johnobrien/printnc/VFD_Modbus_Control/VFD_Modbus_Wiring_Schematic.pdf

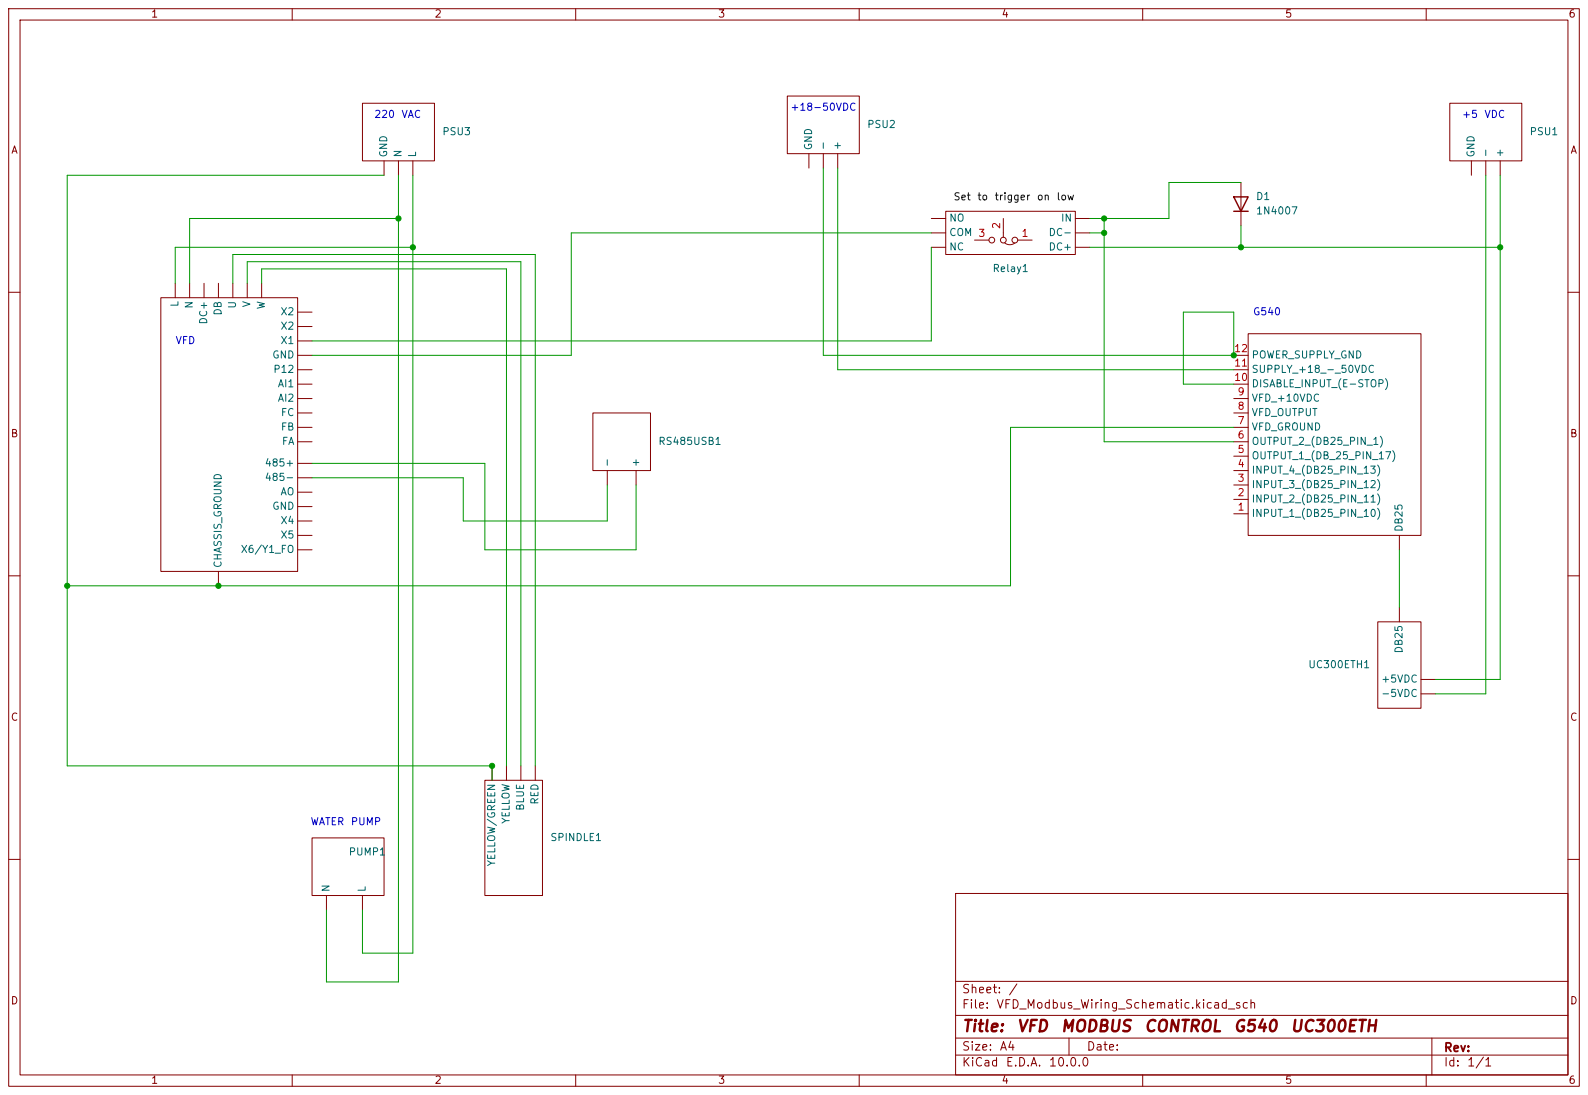
[picture p1: page 1]

Set to trigger on low WATER PUMP

Sheet: / YELLOW/GREEN YELLOW BLUE RED

File: VFD_Modbus_Wiring_Schematic.kicad_sch
Title: VFD MODBUS CONTROL G540 UC300ETH

Size: A4 | Rev:
KiCad E.D.A. 10.0.0 | Id: 1/1
