johnobrien/printnc/VFD_Voltage_Control/VFD_Voltage_Control_Wiring_Schematic.kicad_pcb

## KiCad design v2v 1.2 .kicad_sch

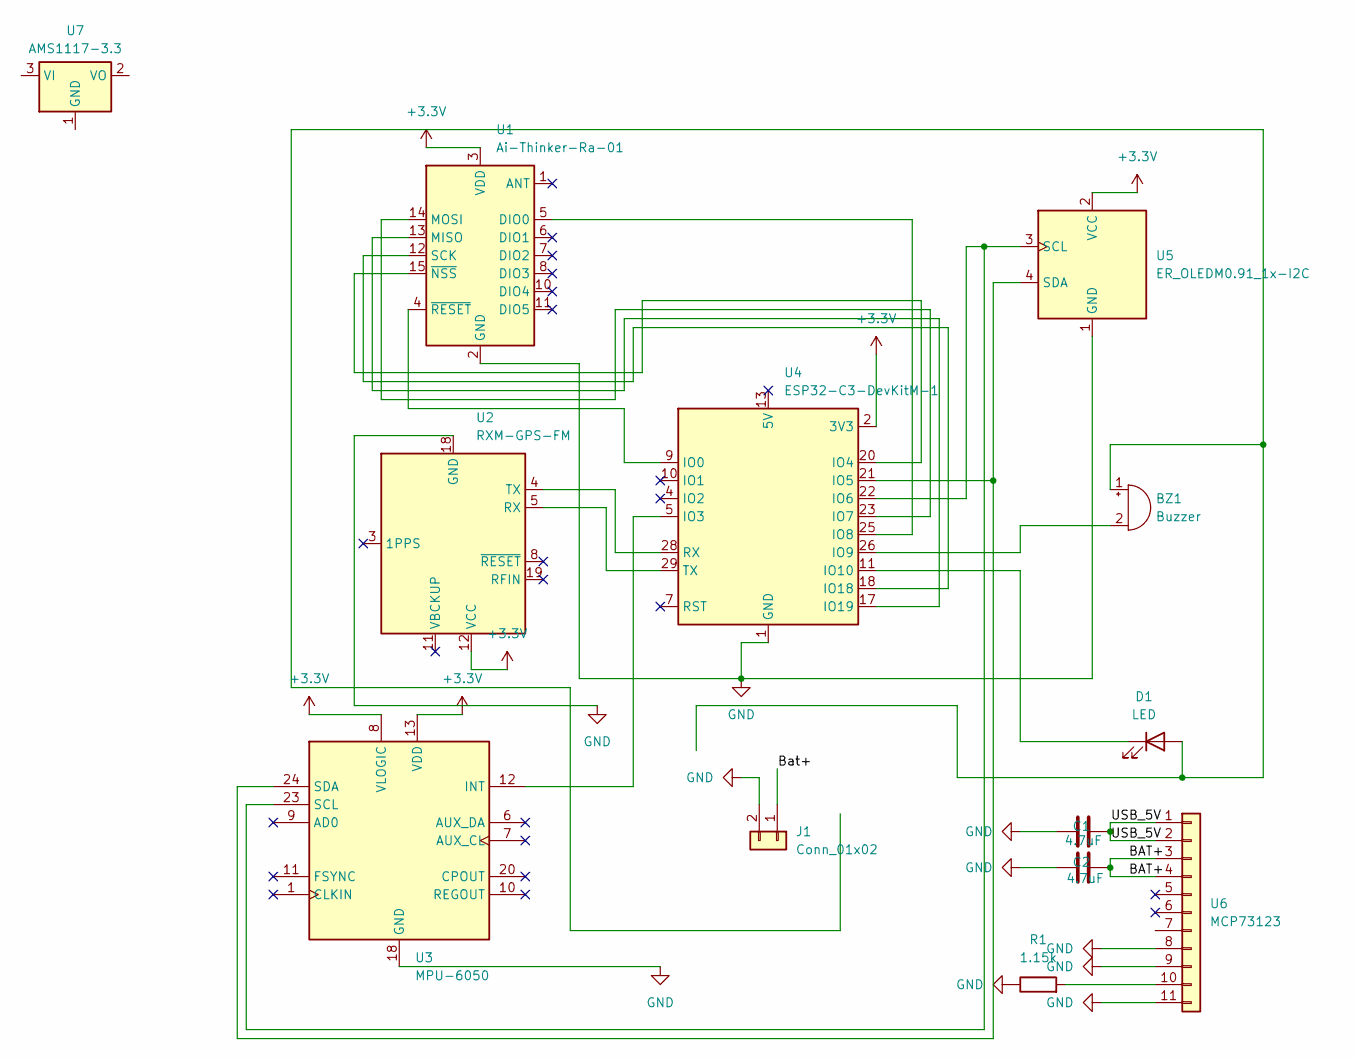
[picture p2: schematic v2v 1.2 .kicad_sch]

Parts:
BZ1: Buzzer
C1, C2: 4.7uF
D1: LED
J1: Conn_01x02
R1: 1.15k
U1: Ai-Thinker-Ra-01; Ai-Thinker-Ra-01-LoRa
U2: RXM-GPS-FM; Linx_RXM-GPS
U3: MPU-6050; InvenSense_QFN-24_4x4mm_P0.5mm
U4: ESP32-C3-DevKitM-1
U5: ER_OLEDM0.91_1x-I2C
U6: MCP73123
U7: AMS1117-3.3; SOT-223-3_TabPin2

Connections:
+3.3V: U1.3 (VDD), U2.12 (VCC), U3.8 (VLOGIC), U3.13 (VDD), U4.2 (3V3), U4.3 (3V3), U5.2 (VCC)
BAT+: C2.1, J1.1, U6.3, U6.4
GND: C1.1, C2.2, J1.2, R1.1, U1.2 (GND), U1.9 (GND), U1.16 (GND), U2.18 (GND), U2.20 (GND), U2.21 (GND), U2.22 (GND), U3.18 (GND), U4.1 (GND), U4.6 (GND), U4.8 (GND), U4.12 (GND), U4.15 (GND), U4.16 (GND), U4.19 (GND), U4.24 (GND), U4.27 (GND), U4.30 (GND), U5.1 (GND), U6.8, U6.9, U6.11
unnamed: BZ1.1 (+), D1.2 (A)
unnamed: BZ1.2 (-), U4.26 (IO9)
unnamed: D1.1 (K), U4.11 (IO10)
unnamed: R1.2, U6.10
unnamed: U1.4 (~RESET), U4.9 (IO0)
unnamed: U1.5 (DIO0), U4.25 (IO8)
unnamed: U1.12 (SCK), U4.18 (IO18)
unnamed: U1.13 (MISO), U4.17 (IO19)
unnamed: U1.14 (MOSI), U4.23 (IO7)
unnamed: U1.15 (~NSS), U4.20 (IO4)
unnamed: U2.4 (TX), U4.28 (RX)
unnamed: U2.5 (RX), U4.29 (TX)
unnamed: U3.12 (INT), U4.5 (IO3)
unnamed: U3.23 (SCL), U4.22 (IO6), U5.3 (SCL)
unnamed: U3.24 (SDA), U4.21 (IO5), U5.4 (SDA)
unnamed: U4.13 (5V), U4.14 (5V)
USB_5V: C1.2, U6.1, U6.2
