johnobrien/printnc/(commit log)

2026-03-30 Reorganized, created PDF of schematic
    [VFD_Voltage_Control_Wiring_Schematic.kicad_pcb, VFD_Voltage_Control_Wiring_Schematic.kicad_sch]
2026-03-30 Added schematic to git repo
    [VFD_Modbus_Wiring_Schematic.kicad_sch]
2026-03-30 Added the wiring to tie the grounds for the 5V PSU and the G540 PSU
    [VFD_Modbus_Wiring_Schematic.kicad_sch]
2026-04-01 Got voltage control working using two relays.
    [VFD_Modbus_Wiring_Schematic.kicad_sch, VFD_Voltage_Control_Wiring_Schematic.kicad_sch]
